pkarcsi55/-Smart-Electroscope/BOM.md

## 📋 Alkatrészlista (BOM)

| Név | Pozíció (Designator) | Mennyiség |
|---|---|---|
| 10 µF 16V | C1, C2 | 2 |
| 560 pF | C3 | 1 |
| 10 nF | C4 | 1 |
| LED-TH-5mm_R | RL1, RL2 | 2 |
| LED-TH-5mm_G | GL1, GL2 | 2 |
| 1 kΩ | R1, R2 | 2 |
| 8,1 kΩ | R3 | 1 |
| 3,9 kΩ | R4 | 1 |
| 56 Ω | R5, R6, R7, R8 | 4 |
| 3,9 kΩ | R9 | 1 |
| 5,6 kΩ | R10 | 1 |
| TS-1103S-C-K_C2940638 | SW1 | 1 |
| TLC272 | U1 | 1 |
| LOLIN-Lite-ESP32 | U2 | 1 |
| DG444DJ-E3 | U3 | 1 |
| Mini boost DC-DC converter | U4 | 1 |
| BH-18650 | BT1 | 1 |
