pkarcsi55/-Smart-Electroscope/Schematic_ELECTROSCOPE_2025-10-31.pdf

# D3 10 S3 11 VL 12 V+ 13 S2 14 D2 15 IN2 16

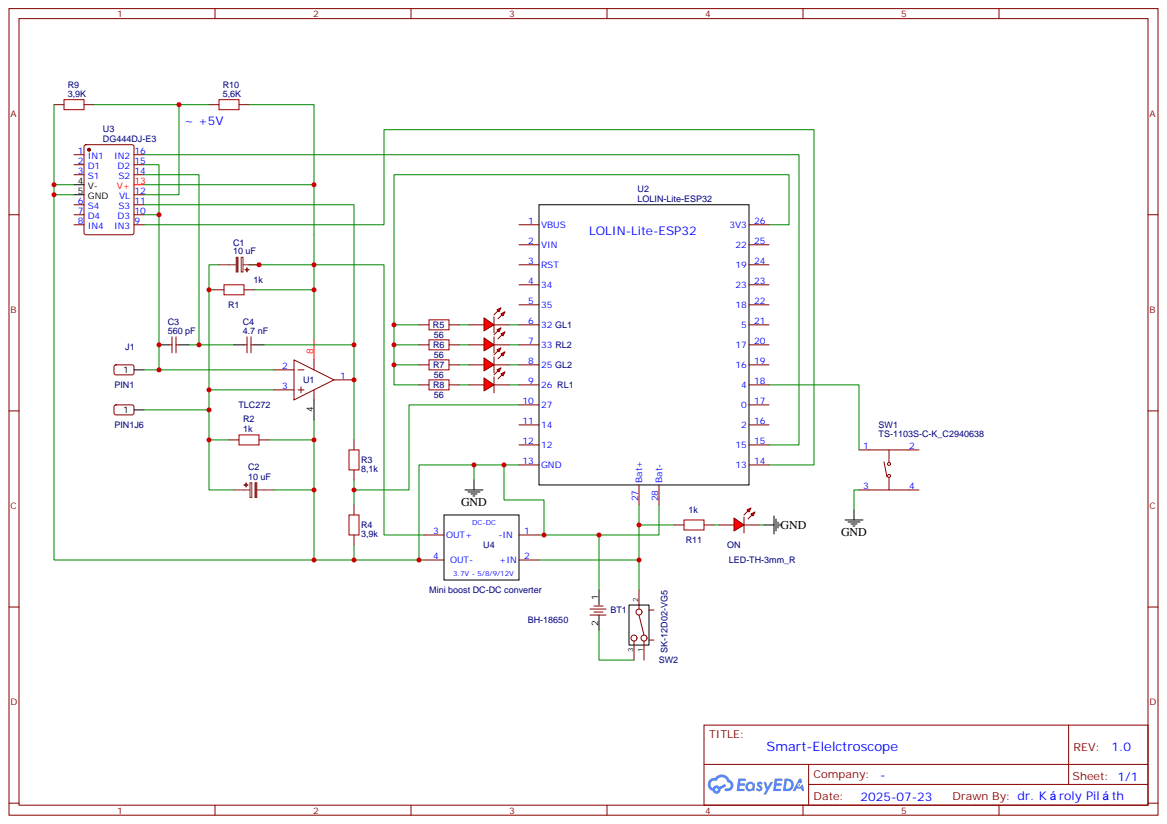
[picture p1: page 1]

Mini boost DC-DC converter

Drawn By: dr. K roly Pil th
