pkarcsi55/-Smart-Electroscope/(list of files, drawings)

Other design files:
SCH_ELECTROSCOPE_2025-04-18.json
