pkarcsi55/-Smart-Electroscope/(commit log)

2025-04-18 Add files via upload
    EasyEda kapcsolási rajz
    [SCH_ELECTROSCOPE_2025-04-18.json]
2025-04-18 Add files via upload
    A nyomtatott áramköri lap (NYÁK) gyártásához szükséges Gerber fájlokat
2025-10-31 PCB design (Gerber files) for the Smart Qmeter device.
2025-10-31 Arduino source code for the Smart Electroscope (ESP32-based charge sensor).
    martElectroscope.ino – main Arduino sketch for the Smart Electroscope (Smart Qmeter) hardware.
    It runs on an ESP32 microcontroller and measures the electric flux (related to charge) through a sensing electrode.
    The measured values are transmitted via Bluetooth to the Android app for real-time visualization.
2025-10-31 Circuit schematic of the Smart Electroscope hardware.
    Schematic_ELECTROSCOPE_2025-10-31.pdf – full circuit diagram of the Smart Electroscope hardware.
    The schematic shows the ESP32 microcontroller, amplifier and signal-conditioning stage, power supply, and the sensing electrode connections.
    Designed with EasyEDA; this version corresponds to the 2025-10-31 hardware release.
2025-10-31 Circuit schematic of the Smart Electroscope hardware.
    Schematic_ELECTROSCOPE_2025-10-31.pdf – full circuit diagram of the Smart Electroscope / Smart Qmeter hardware.
    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
2025-11-02 All 3D print files are available in obj format.
